matatma23-gento/TinySign_Verilog/artifacts/proposal_peruri_20261008/artifact.md

# Proposal template execution contract
Reference: /home/mateus/Documents/Peruri/TinySign_Verilog/artifacts/proposal_peruri_20261008/source/proposal_original.docx
SHA-256: 44618d00adb0bb25e647392200d773ac85fa8586c9a02877332da785d1b47b0f
Original Google PDF and DOCX render: six pages (four main, two references/appendix), one Letter portrait section.
Page geometry: 8.5 x 11 in, margins top 0.97778, bottom 1.05486, left 1.0, right 0.625 in. Preserve geometry and existing headers/footers.
Typography: Arial 11 pt body, original title 26 pt bold, category 15 pt, major section 20 pt. Preserve identity names, institutions, contacts, advisor, team name; remove only [ … ] placeholder before known team name. Black text, source heading hierarchy; regular section titles.
Slots: original title/category/identity paragraphs 0–9 retained except project title; paragraphs 10–42, technical tables 0–1 and verification diagram replaced because verification-only scope contradicts active signing RTL. Paragraphs 43+ reference/appendix and tables 2–3 retained, except project-specific demo/roadmap descriptions updated to actual status; member-role placeholders remain untouched.
Six main pages include identity. Page 7 starts references. Insert runtime results and power estimates, embed timing image on main page 4; detailed control trace is appendix. Preserve all source reference items, add RFC6979 and project results references.
All unchanged ZIP parts except document.xml, relationships/content types and media should remain identical; opaque existing parts preserved by package transplant if needed. Source file stays unchanged. Page breaks introduced to meet six-page main limit. No fabricated roles or board/ASIC success.
