matatma23-gento/TinySign_Verilog/memory/2026-10-08.md

## TinySign / Quartus DE10-Nano
- User is developing proposal “TinySign: Hardware Security Element untuk Secure Digital Signing Berbasis ECDSA P-256 pada Identitas dan Dokumen Digital” for PERURI ChipHackathon 2026.
- Quartus Prime Lite 20.1 is installed at `/home/mateus/intelFPGA_lite/20.1`; project at `/home/mateus/Documents/Peruri/TinySign_Verilog`.
- Full TinySign compilation successfully fit only on target `5CGXFC7C7F23C8` with reported ~45,915 ALMs / 56,480 (81%), 68,143 registers, Fmax about 141.68 MHz, 0 RAM/DSP, and produced `quartus/output_files/TinySign.sof`. This bitstream is not compatible with DE10-Nano.
- DE10-Nano target is `5CSEBA6U23I7` with 4,191 LABs. Full design currently fails Fitter at roughly 4,734 LABs (latest reported), so no valid DE10-Nano full-core SOF exists yet. Compiler settings alone are insufficient; RTL resource-sharing/serial refactor is required while preserving ECDSA P-256, RFC6979, SHA-256/HMAC, key isolation, zeroization, and constant-time scheduling.
- `point_ops.v` already contains one `mod_mul` instance; do not claim unimplemented point-level multiplier sharing. Remaining duplication likely includes ECC datapaths in key manager/signer and other 256-bit registers/engines.
- The supposed `TinySignSelftest` project still instantiates `tinysign_core` through `rtl/test_support/tinysign_board_selftest.v:26`, so it is not a lightweight board-only self-test and also exceeds DE10-Nano capacity. To make a board smoke-test SOF, remove the `tinysign_core` dependency and crypto RTL assignments from `quartus/selftest/TinySignSelftest.qsf`, retaining only clock/reset/LED/UART test logic; clean `db`, `incremental_db`, and `output_files`, then compile from `quartus/selftest`.
- Important: distinguish a board-only self-test SOF from the full TinySign ECDSA SOF; never program the 5CGXFC7C7F23C8 SOF into a DE10-Nano.
# 2026-10-08 Durable Memories

- **User Context**: Tege (gateway-owner) is working on **TinySign**, a Hardware Security Element for Secure Digital Signing (ECDSA P-256) for the PERURI ChipHackathon 2026.
- **Hardware Target**: Terasic DE10-Nano (Intel Cyclone V 5CSEBA6U23I7).
- **Environment**: Quartus Prime Lite 20.1 installed at `/home/mateus/intelFPGA_lite/20.1/quartus`. `composio` CLI v0.4.1 available.
- **Technical Challenge**: The original full-parallel architecture requires ~4,700 LABs, exceeding the DE10-Nano's capacity of 4,191 LABs (Error 170012/11802).
- **Milestone (Success)**: Successfully compiled bitstream `.sof` for a larger device (`5CGXFC7C7F23C8`) showing 81% ALM utilization and Fmax of 141.68 MHz. Produced a formal hardware analysis report in PDF.
- **Decision/Directive**: User wants to fit the design on DE10-Nano. I must refactor the RTL (`point_ops.v`, `scalar_mult.v`, `key_manager.v`) to use **resource-sharing (shared/serial multipliers)** and **sequential datapath** to reduce logic usage while preserving security features (ECDSA, RFC 6979, Zeroization, Key Isolation).
- **Current State**: `TinySignSelftest` project also needs isolation from the large core to provide a basic board functionality test image.

## PURI-Sign shared-engine refactor (20:20 WIB)
- User now calls the project PURI-Sign (Protected Utility for Reliable Identity) and requested the full ECDSA design fit DE10-Nano.
- Refactored active `.v` RTL: key_manager/ecdsa_signer support SHARED_ENGINES; tinysign_core selects shared mode and owns one scalar_mult, one mod_inv, one top-level mod_mul. Total hierarchical multipliers 8 -> 4. RFC6979/HMAC were never duplicated between these controllers.
- Isolated project `quartus/puri_sign/TinySign.qpf` successfully fit `5CSEBA6U23I7`: 27,853 ALMs needed vs old 46,158; physical ALMs placed 32,834; LABs occupied 3,971/4,191; 45,242 registers. Assembler generated SOF, but this is an Avalon-MM shell with no exact board pin assignments, not a board-ready image.
- Initial 50 MHz timing FAILED (setup -5.006 ns, Fmax 39.99 MHz). Isolated project's SDC changed to 25 MHz and quartus_sta reanalyzed the same fitted netlist: all constrained internal paths pass all corners (worst setup +14.994 ns, hold +0.113 ns). SDC does not divide physical clock: integration needs a real 25 MHz PLL/HPS clock, appropriate Avalon domain/bridge, board pin and I/O delay constraints. Original quartus/TinySign.sdc remains 50 MHz.
- Targeted regressions pass: nine Python tests; Icarus HMAC/RFC6979 and d=1 core; Verilator shared-engine public key/signature RFC6979, repeat latency, abort during scalar and nonce inversion, busy rejection, reprovision recovery, plus standalone key manager/signer and Avalon shell. Core signing 7,437,840 cycles -> 297.5136 ms at 25 MHz. No board test performed.
- Evidence: reports/puri_sign/results.md + results.json; docs/puri_sign_area.md. Baseline RTL/report backup: .refactor_backup/shared_engines_20261008/. Local temporary simulators downloaded/extracted under /tmp/puri-sign-tools, no system package installation.

## PURI-Sign quantitative analysis (20:35 WIB)
- User requested quantitative area, compute/performance, and power estimates. Created reports/puri_sign/quantitative/rancangan_kuantitatif.md and metrics.json with evidence.
- Re-simulated baseline .v controllers from .refactor_backup/shared_engines_20261008 via Verilator: signing 7,437,840 core cycles, provisioning 7,303,706 core cycles; signature/zeroize pass. Same signing cycles as shared design, so no same-clock speedup (1.00x, 0%); normalized throughput/ALMs-needed improves 65.72%. Resource reductions: ALMs needed 39.66%, placed ALMs 27.30%, registers 33.36%. Fixed FPGA die size is unchanged.
- Ran quartus_pow on candidate at 25 MHz: total thermal 578.77 mW, dynamic core 150.04 mW, static core 413.52 mW, I/O 15.22 mW; confidence LOW, no VCD/SAF, input default toggle 12.5%, vectorless on. Typical device, VCC 1.10 V, ambient 25 C, junction estimated 28.6 C. HPS active power and board thermal model absent; some clock domains indeterminate. This is not board power or measured signature energy; no comparable baseline power exists, so do not claim a before/after power-saving percentage.

## Latest SOF assembly (20:39 WIB)
- User requested latest SOF. Verified all active RTL/QSF/25 MHz SDC hashes against validated manifest, archived prior assembly in reports/puri_sign/sof_archive/20261008_203852/, and reran Quartus Assembler successfully (0 errors).
- Deliverable: artifacts/PURI_Sign_core_20261008_2039/PURI_Sign_core_5CSEBA6U23I7.sof, 6,690,356 bytes. Manifest, checksum, fit/timing/assembler evidence included. This reuses existing fit; it remains an Avalon-MM core shell, NOT board-ready, requiring actual 25 MHz clock plus board pin/IO/host integration before programming.

## PURI-Sign timing diagrams
- Generated reports/puri_sign/timing/ with three inspected PNG/SVG control diagrams (overview, signing detail, handshake/zeroize), compact control_events.vcd/CSV, timing_summary.json, and README. Sources: tb/tb_puri_timing.v and scripts/render_puri_timing.py. No synthesizable RTL changes.
- Verilator simulation at 25 MHz passed signature readback for d=1 / SHA256(sample) and zeroize during active shared scalar. Provisioning 7,303,706 cycles = 292.14824 ms; signing 7,437,840 cycles = 297.5136 ms. RTL simulation stimulus, not hardware/post-route measurement.
- Documented existing sign_valid persistence into a subsequent signing request; host must use new transaction busy/done sequence. Zeroize controls: shared engine stops at acceptance, key/sign flags clear next cycle, core completion two cycles after acceptance.

## PURI-Sign draw.io workflow
- Created docs/diagrams/puri_sign/PURI_Sign_Alur_Sistem.drawio, five editable pages: main workflow, provisioning, ECDSA signing, shared engines, ZEROIZE/error. PNG/SVG previews visually inspected, native XML structure checked, README/manifest/ZIP supplied. Generator scripts/create_puri_drawio.py; no RTL/SOF changes.
- Corrected timing README prose: core sign_valid clears at ZEROIZE acceptance, while key_valid/key_locked clear one cycle later; earlier wording grouped these flags incorrectly.
