matatma23-gento/TinySign_Verilog/docs/diagrams/puri_sign/01_alur_utama.png

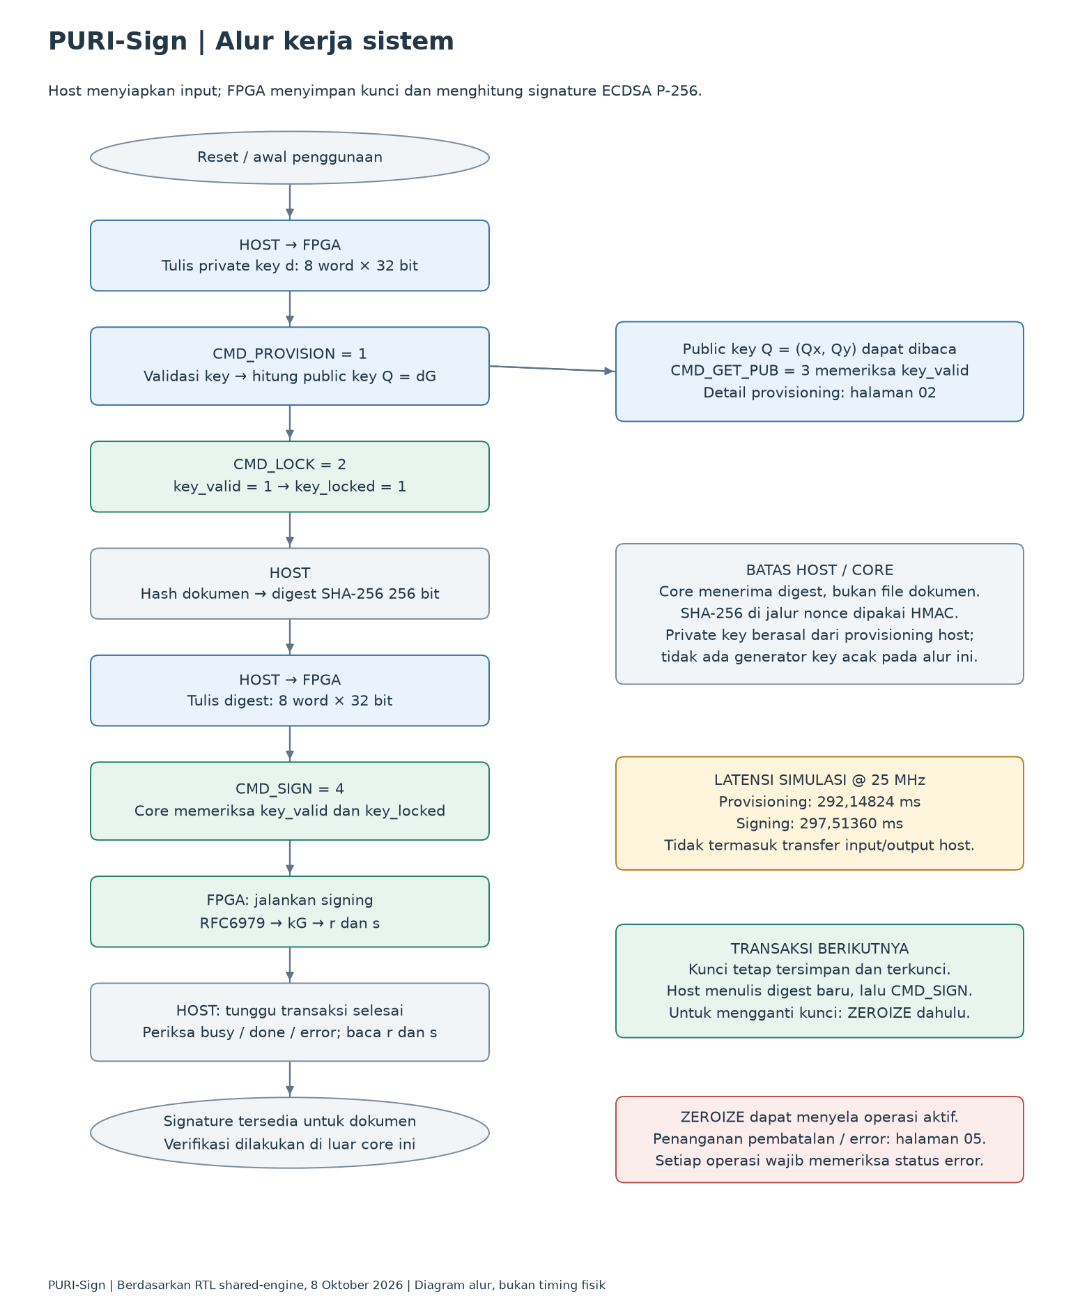
docs/diagrams/puri_sign/01_alur_utama.png
