matatma23-gento/TinySign_Verilog/docs/diagrams/puri_sign/02_provisioning.png

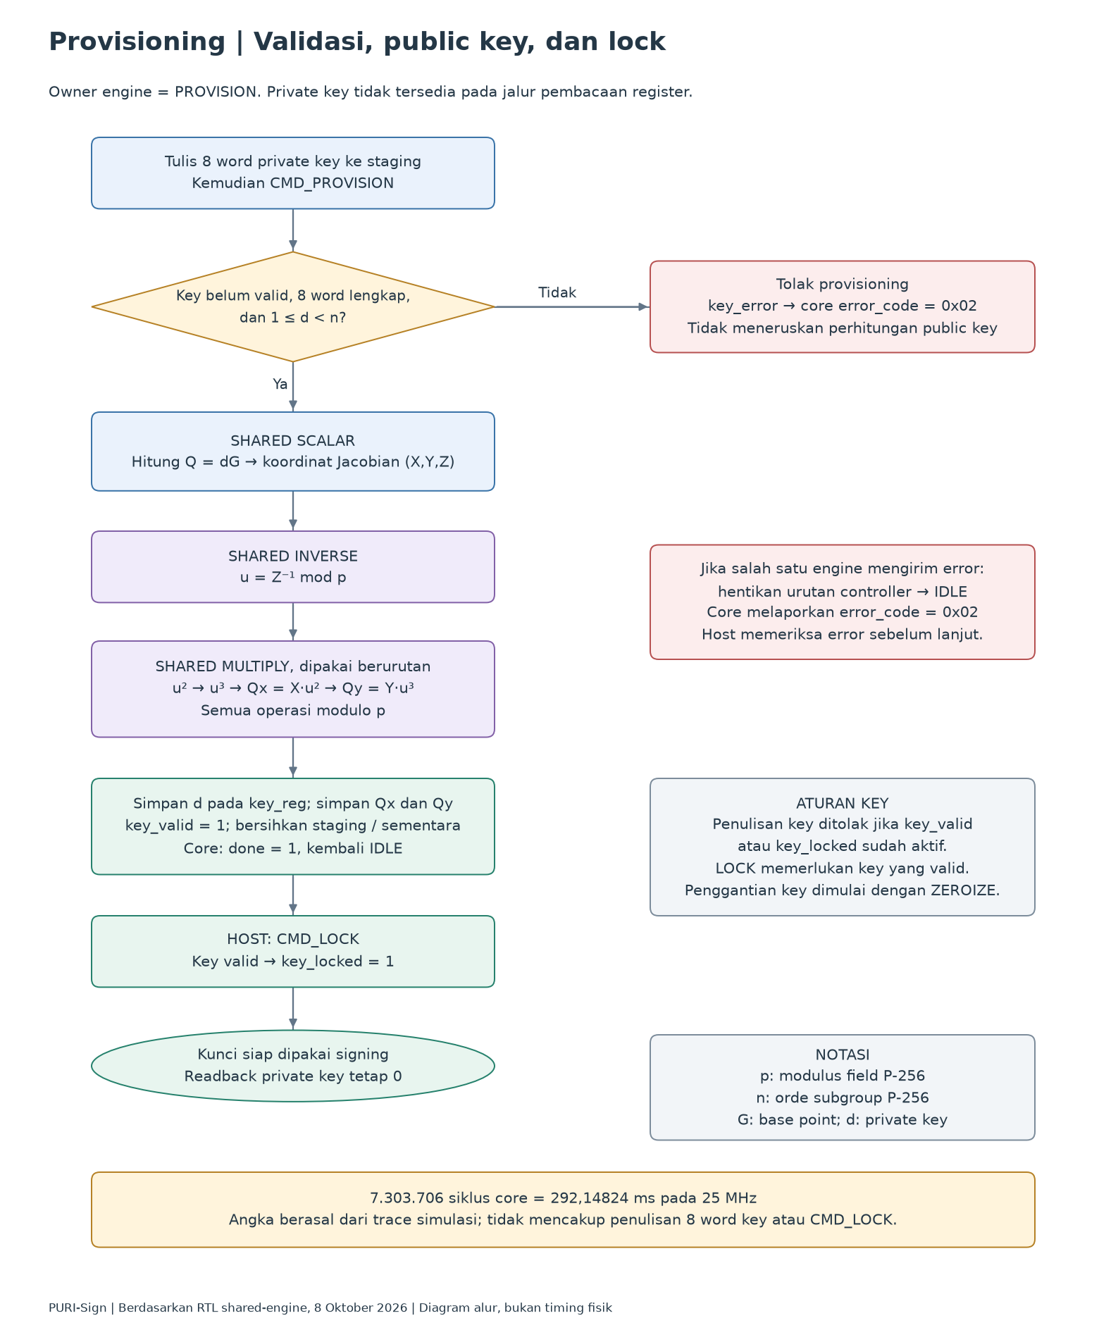
docs/diagrams/puri_sign/02_provisioning.png
