matatma23-gento/TinySign_Verilog/docs/diagrams/puri_sign/03_signing.png

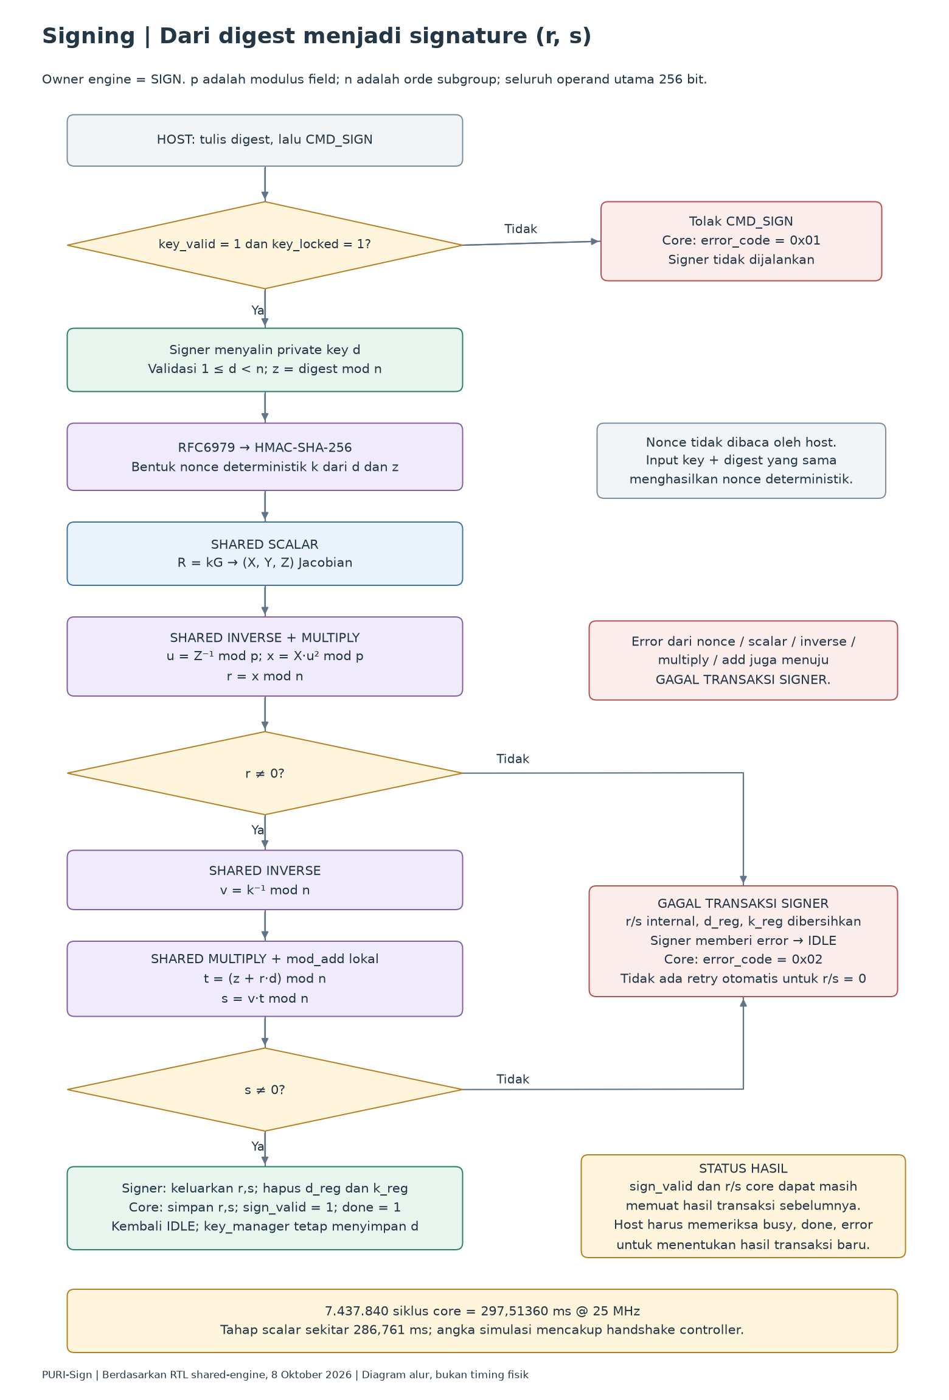
docs/diagrams/puri_sign/03_signing.png
