matatma23-gento/TinySign_Verilog/docs/diagrams/puri_sign/04_engine_bersama.png

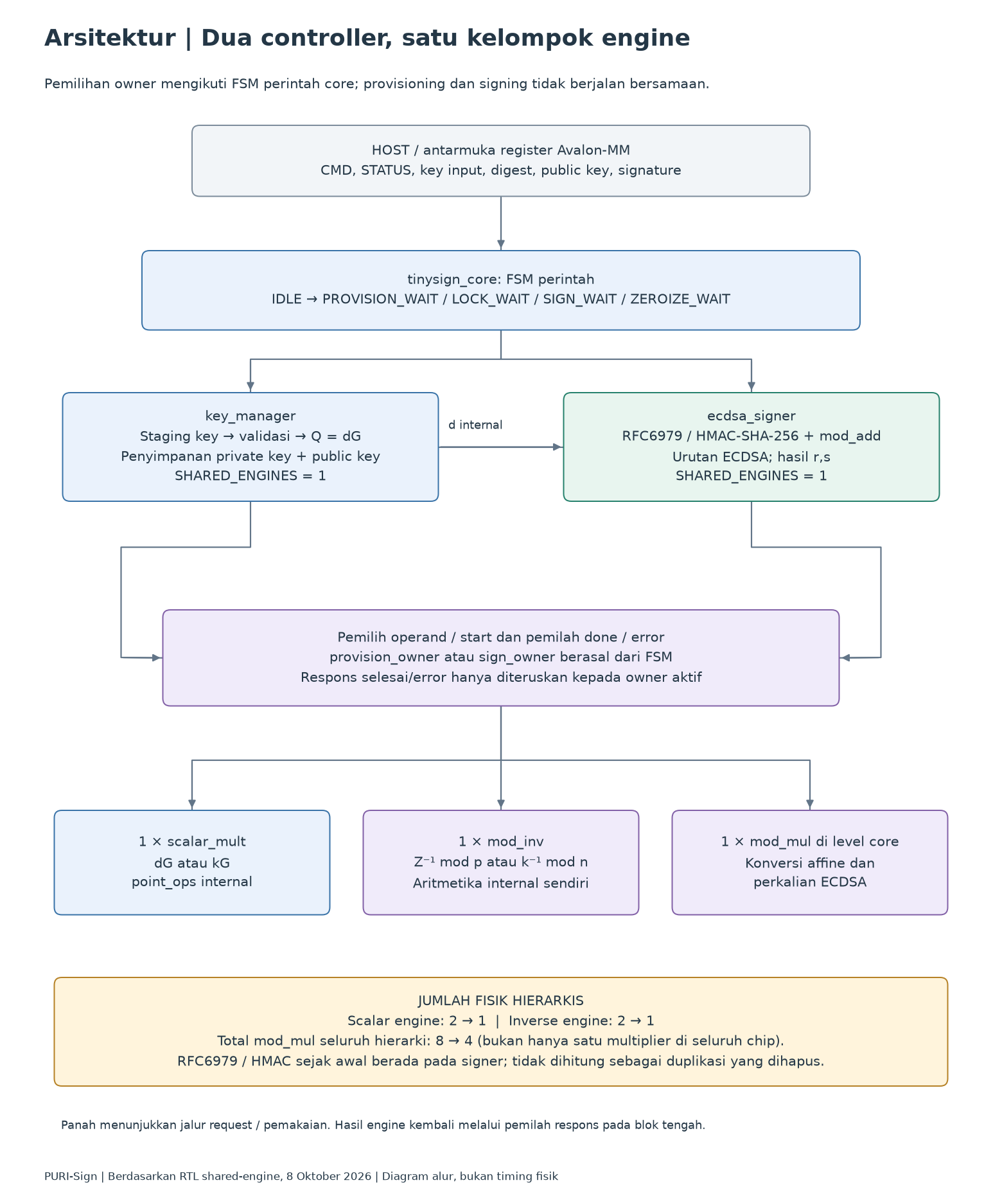
docs/diagrams/puri_sign/04_engine_bersama.png
