matatma23-gento/TinySign_Verilog/docs/diagrams/puri_sign/05_zeroize_error.png

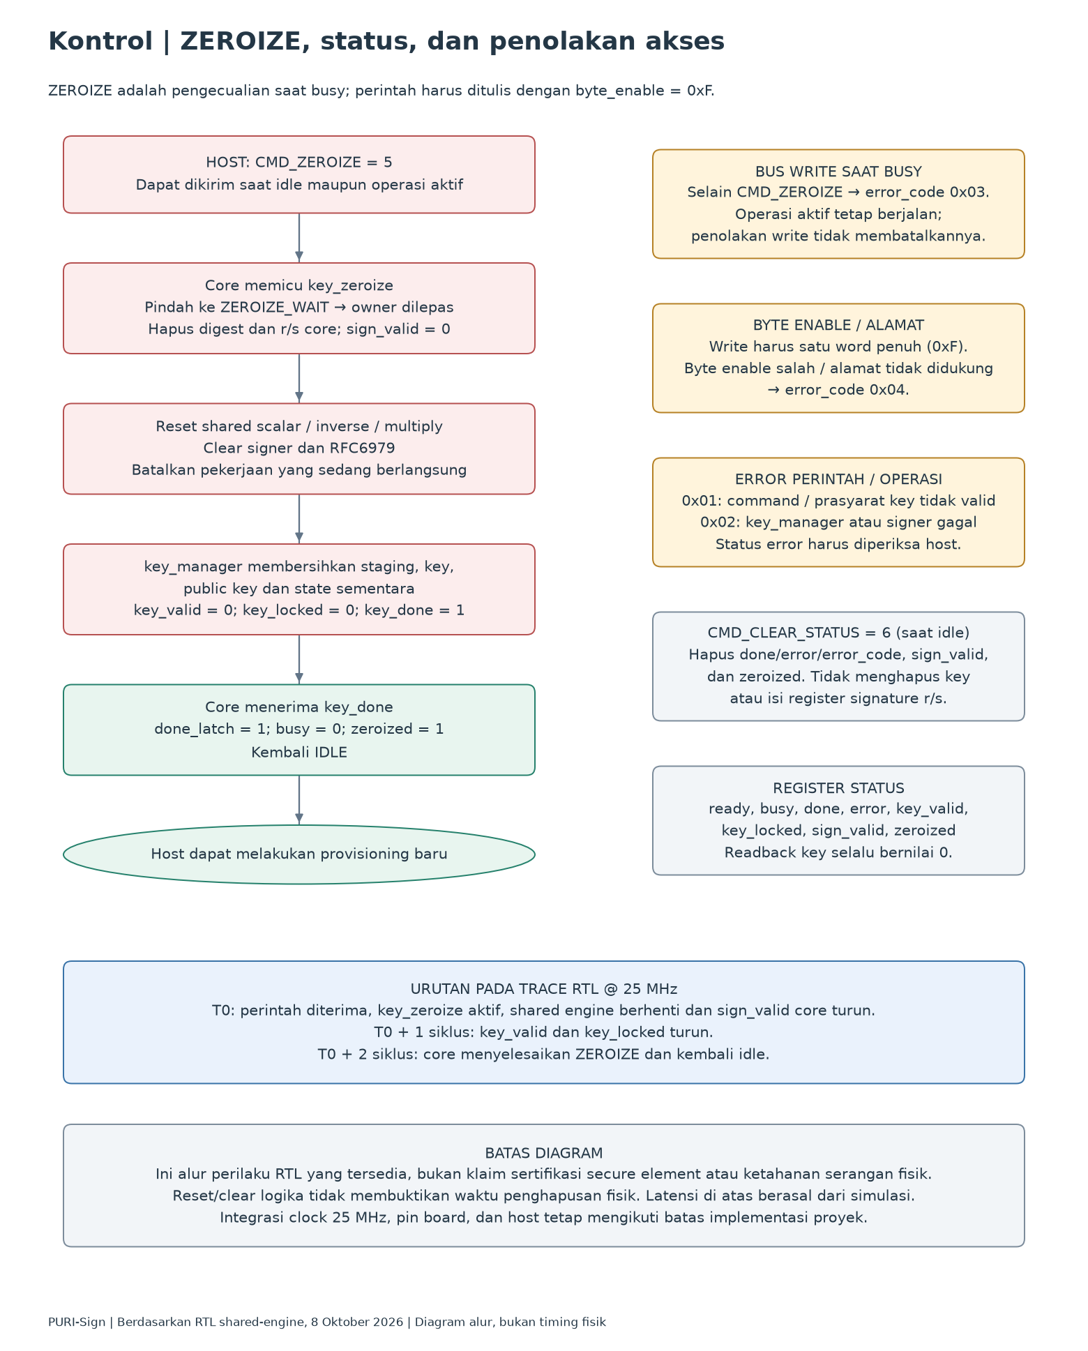
docs/diagrams/puri_sign/05_zeroize_error.png
