matatma23-gento/TinySign_Verilog/reports/testing/board_selftest_trace.csv

cycle | write | busy | key_valid | key_locked | sign_valid | zeroized | finished | passed | key_nonzero | signer_secret_nonzero | step
1 | 0 | 0 | 0 | 0 | 0 | 0 | 0 | 0 | 0 | 0 | 0
2 | 1 | 0 | 0 | 0 | 0 | 0 | 0 | 0 | 0 | 0 | 0
3 | 0 | 0 | 0 | 0 | 0 | 0 | 0 | 0 | 0 | 0 | 1
5 | 1 | 0 | 0 | 0 | 0 | 0 | 0 | 0 | 0 | 0 | 1
6 | 0 | 0 | 0 | 0 | 0 | 0 | 0 | 0 | 0 | 0 | 2
8 | 1 | 0 | 0 | 0 | 0 | 0 | 0 | 0 | 0 | 0 | 2
9 | 0 | 0 | 0 | 0 | 0 | 0 | 0 | 0 | 0 | 0 | 3
11 | 1 | 0 | 0 | 0 | 0 | 0 | 0 | 0 | 0 | 0 | 3
12 | 0 | 0 | 0 | 0 | 0 | 0 | 0 | 0 | 0 | 0 | 4
14 | 1 | 0 | 0 | 0 | 0 | 0 | 0 | 0 | 0 | 0 | 4
15 | 0 | 0 | 0 | 0 | 0 | 0 | 0 | 0 | 0 | 0 | 5
17 | 1 | 0 | 0 | 0 | 0 | 0 | 0 | 0 | 0 | 0 | 5
18 | 0 | 0 | 0 | 0 | 0 | 0 | 0 | 0 | 0 | 0 | 6
20 | 1 | 0 | 0 | 0 | 0 | 0 | 0 | 0 | 0 | 0 | 6
21 | 0 | 0 | 0 | 0 | 0 | 0 | 0 | 0 | 0 | 0 | 7
23 | 1 | 0 | 0 | 0 | 0 | 0 | 0 | 0 | 0 | 0 | 7
24 | 0 | 0 | 0 | 0 | 0 | 0 | 0 | 0 | 0 | 0 | 8
26 | 1 | 0 | 0 | 0 | 0 | 0 | 0 | 0 | 0 | 0 | 8
27 | 0 | 1 | 0 | 0 | 0 | 0 | 0 | 0 | 0 | 0 | 9
7303732 | 0 | 1 | 1 | 0 | 0 | 0 | 0 | 0 | 1 | 0 | 9
7303733 | 0 | 0 | 1 | 0 | 0 | 0 | 0 | 0 | 1 | 0 | 9
7303770 | 1 | 0 | 1 | 0 | 0 | 0 | 0 | 0 | 1 | 0 | 27
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
