matatma23-gento/TinySign_Verilog/artifacts/proposal_peruri_20261008/qa/draft1/page-6.png

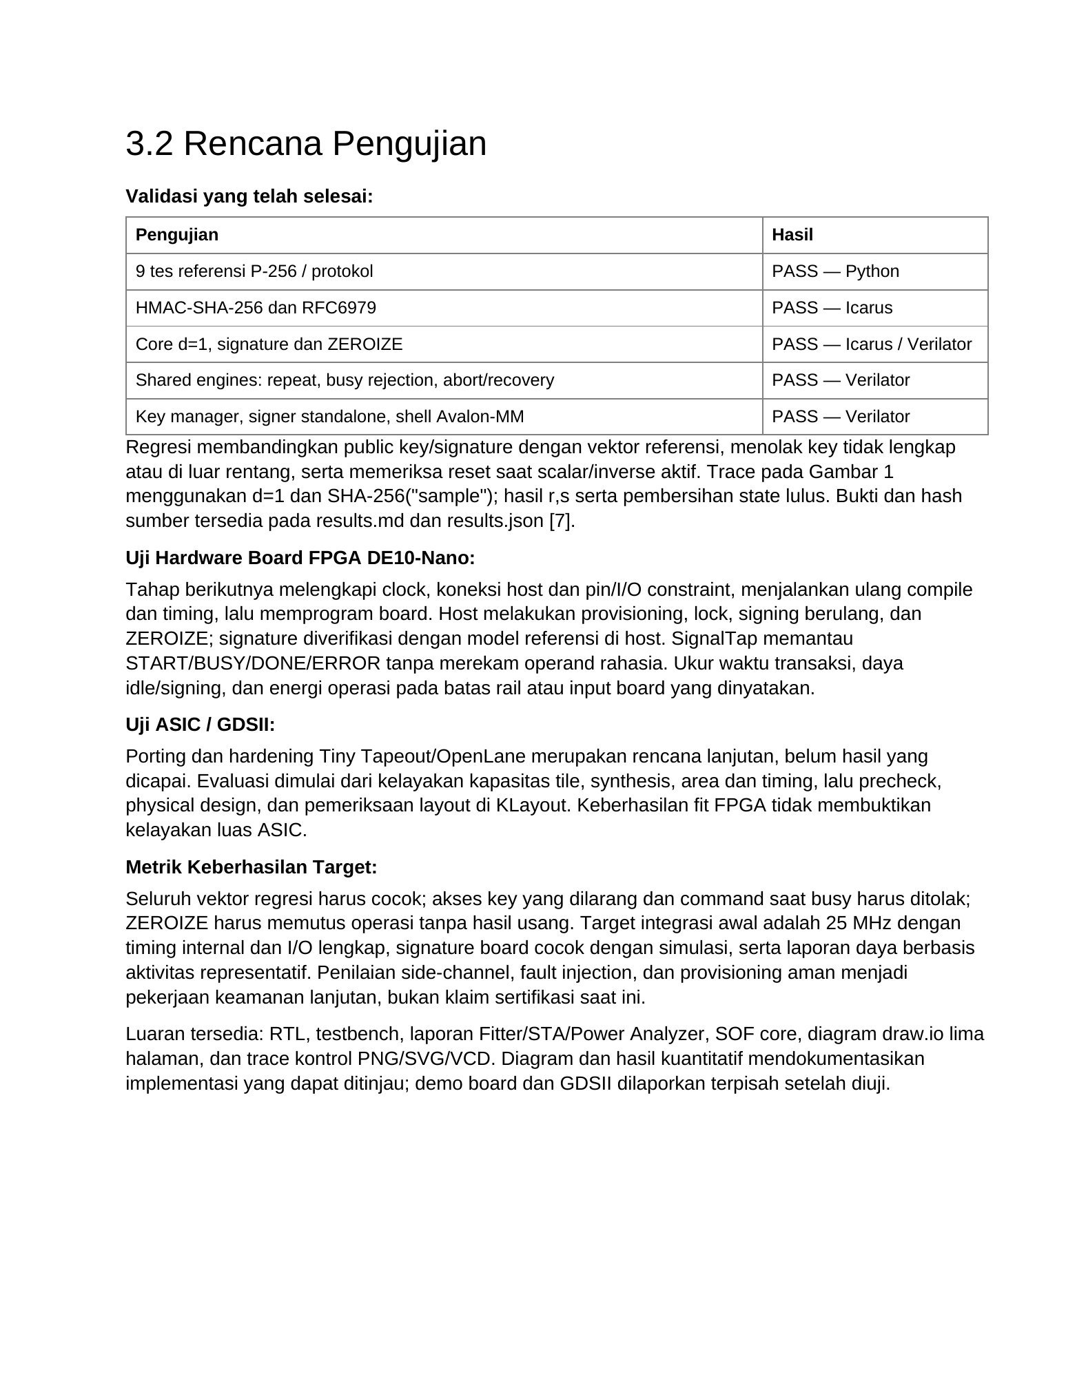
artifacts/proposal_peruri_20261008/qa/draft1/page-6.png
