matatma23-gento/TinySign_Verilog/artifacts/proposal_peruri_20261008/qa/draft2/page-8.png

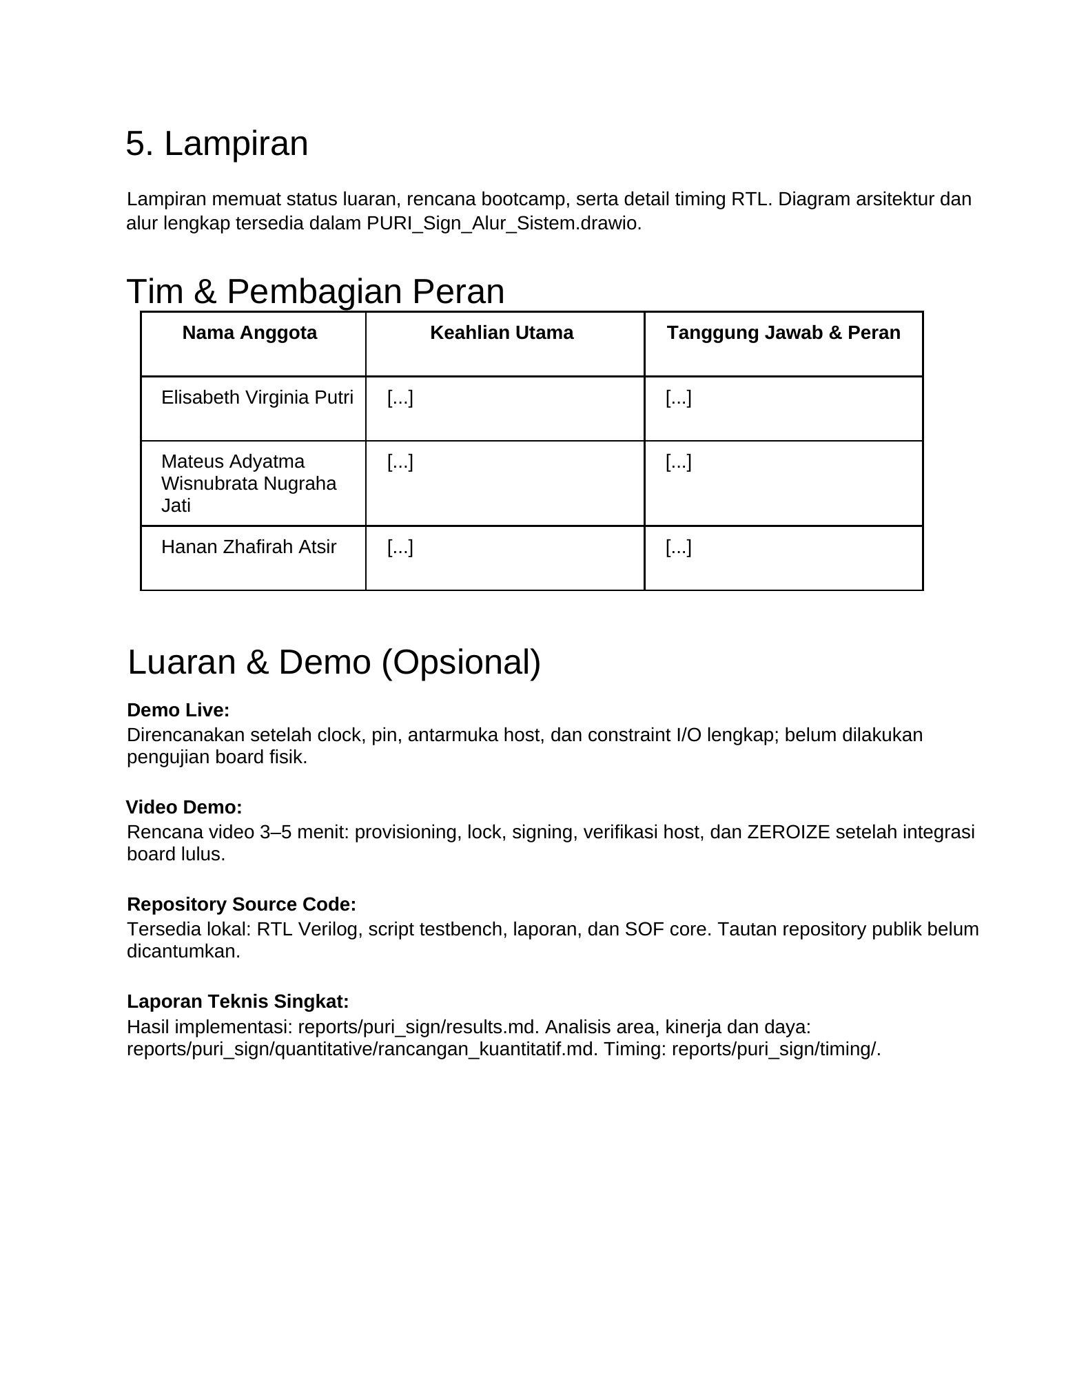
artifacts/proposal_peruri_20261008/qa/draft2/page-8.png
