matatma23-gento/TinySign_Verilog/artifacts/proposal_peruri_20261008/qa/online1/page-3.png

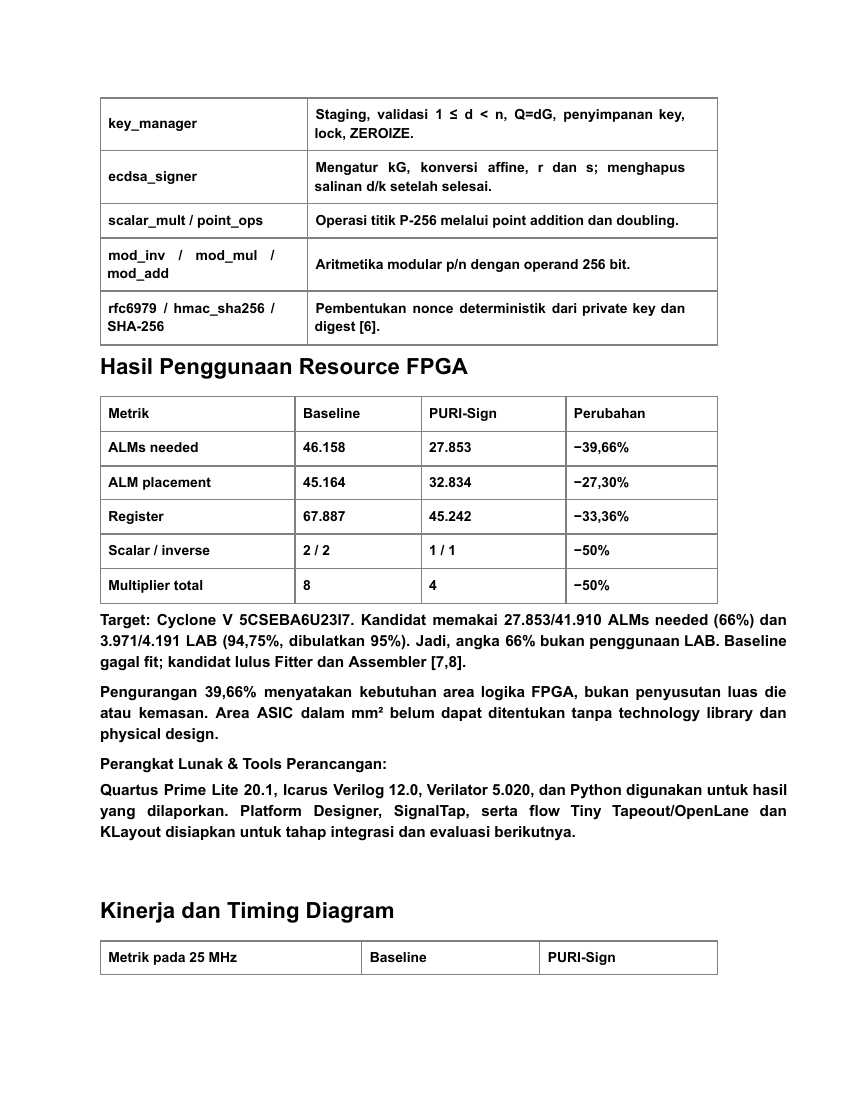
artifacts/proposal_peruri_20261008/qa/online1/page-3.png
