matatma23-gento/TinySign_Verilog/artifacts/proposal_peruri_20261008/qa/original/page-1.png

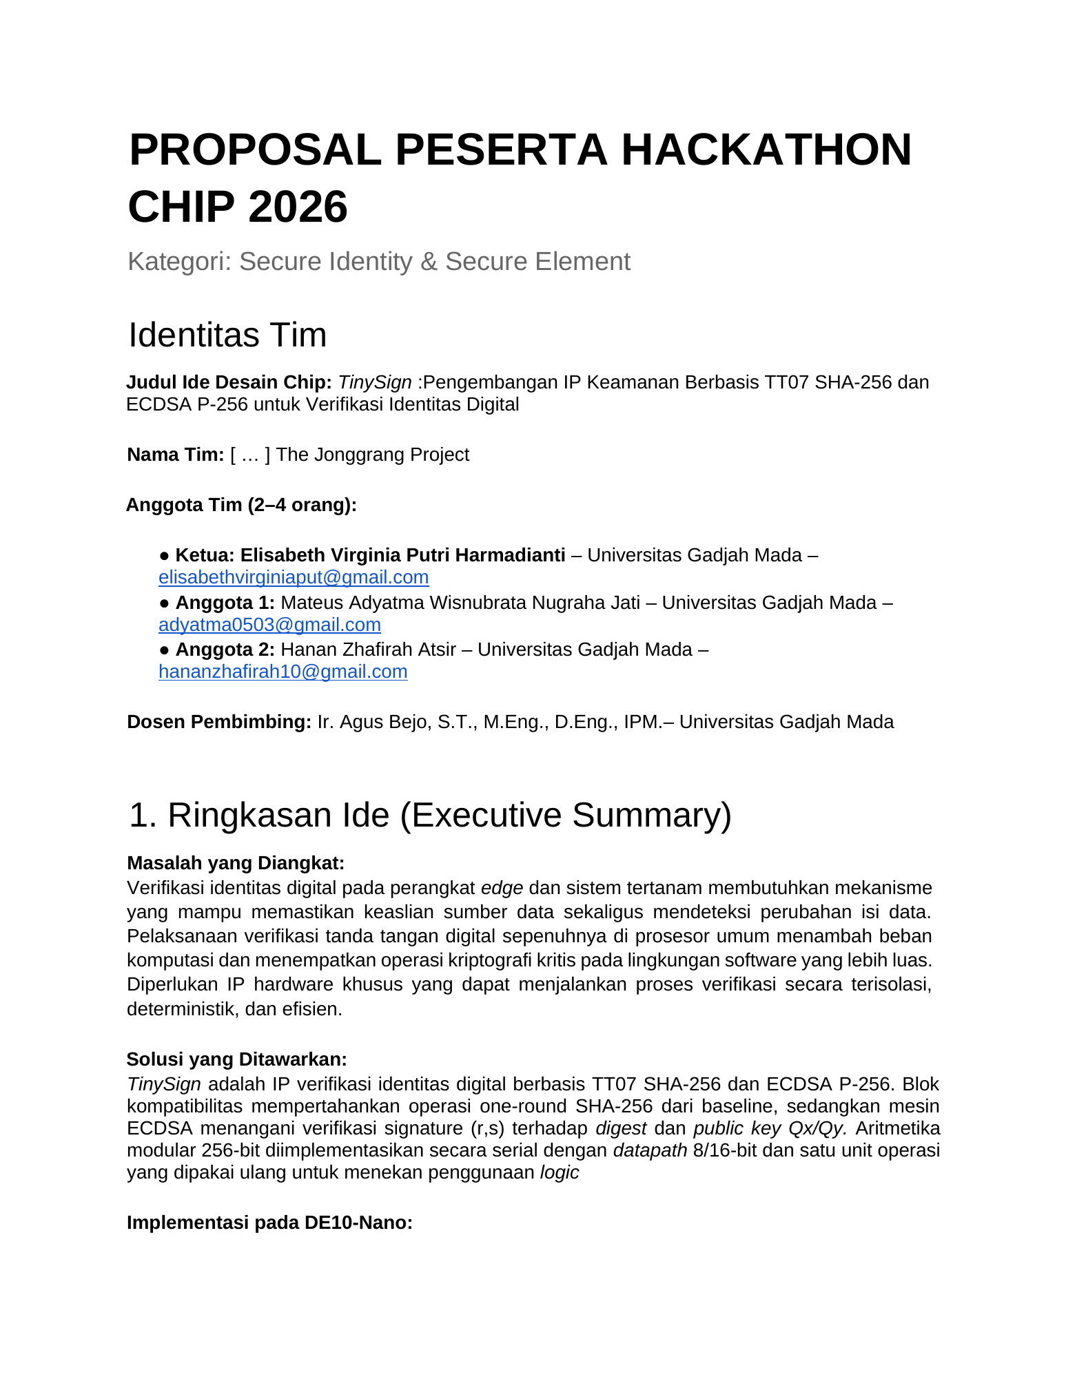
artifacts/proposal_peruri_20261008/qa/original/page-1.png
